dimaib/Current_meter/schematic_pcb/current_rich/спецификация.xlsx

На схеме | Номинал | Артикул | Ссылка | Цена за шт | Кол-во | Цена общ
C2 | CP | TKR470M1JE11 | https://www.chipdip.ru/product0/995239112 | 11 | 1 | 11
> C1, C3, C5-C7, C9 | 0.1uF | MLCC0.1uFY5V50V+80-20%0805 | https://www.chipdip.ru/product0/642412305 | 4 | 6 | 24
C4 | 68uF | ECASD40G686M020K00 | https://www.chipdip.ru/product/ecasd40g686m020k | 15 | 1 | 15
C8 | 10uF | GRM21BR60J106KE19L | https://www.chipdip.ru/product/grm21br60j106k | 4 | 1 | 4
> D1, D2 | SS16 | SS16 | https://www.chipdip.ru/product/ss16 | 4 | 2 | 8
J1 | USB_B_Micro | USB/M-1J (DS1104) | https://www.chipdip.ru/product/usb-m-1j | 23 | 1 | 23
J2 | Conn_01x04 | PLS-4R (DS1022-1x4R) | https://www.chipdip.ru/product/pls-4r | 6 | 1 | 6
J3 | Conn_01x08 | DG308-2.54-02P-14-00AH | https://www.chipdip.ru/product/dg308-2.54-02p-14-00ah | 9 | 4 | 36
L1 | 1000uH | LQH55DN102M03L | https://www.chipdip.ru/product/lqh55dn102m03l | 34 | 1 | 34
pack1 | box | КР-7 "На защелках" (Черный) | https://www.chipdip.ru/product0/9000309028 | 140 | 1 | 140
> Q1-Q4 | BC817 | BC817-16.215 | https://www.chipdip.ru/product/bc817-16-nxp | 3 | 4 | 12
> R1, R2 | R |  |  |  | 2 | 0
R3 | 1.2k | 0.1Вт 0603 1.2 кОм, 1% | https://www.chipdip.ru/product0/9000079678 | 0.9 | 1 | 0.9
R4 | 680 | 0.1Вт 0603 680 Ом, 1% | https://www.chipdip.ru/product0/9000079672 | 0.9 | 1 | 0.9
> R5-R16 | 220 | 0.1Вт 0603 220 Ом, 1% | https://www.chipdip.ru/product0/9000079624 | 0.9 | 12 | 10.8
> R17, R22 | 100 | 0.1Вт 0603 100 Ом, 1% | https://www.chipdip.ru/product0/9000079616 | 0.9 | 2 | 1.8
> R18, R19, R21 | 10k | 0.1Вт 0603 10 кОм, 1% | https://www.chipdip.ru/product0/9000079736 | 0.9 | 3 | 2.7
R20 | 100k | 0.1Вт 0603 100 кОм, 1% | https://www.chipdip.ru/product0/9000079760 | 0.9 | 1 | 0.9
R23 | 5.6k | 0.1Вт 0603 5.6 кОм, 1% | https://www.chipdip.ru/product0/9000079730 | 0.9 | 1 | 0.9
SW1 | Reset | 1437566-3 (FSMSM) | https://www.chipdip.ru/product/tyco-1437566-3-fsmsm | 22 | 1 | 22
SW2 | Boot0 | 1437566-3 (FSMSM) | https://www.chipdip.ru/product/tyco-1437566-3-fsmsm | 22 | 1 | 22
SW3 | Sys | 1437566-3 (FSMSM) | https://www.chipdip.ru/product/tyco-1437566-3-fsmsm | 22 | 1 | 22
U1 | STM32F030F4P6 | STM32F030F4P6 | https://www.chipdip.ru/product/stm32f030f4p6 | 40 | 1 | 40
U2 | CC56-12GWA | CC56-12GWA | https://www.chipdip.ru/product/cc56-12gwa | 210 | 1 | 210
U3 | MAX5035AUSA | MAX5035BASA+T | https://www.chipdip.ru/product/max5035basa | 150 | 1 | 150
U4 | 74HC595 | 74HC595D,118 | https://www.chipdip.ru/product/74hc595d | 10 | 1 | 10
> U8, U11 | LM321 | LM321MF/NOPB | https://www.chipdip.ru/product/lm321mf-nopb-3 | 27 | 2 | 54
U9 | AP1117-33 | AMS1117-3.3 | https://www.chipdip.ru/product/ams1117-3.3 | 16 | 1 | 16
U10 | CP2102N-A01-GQFN28 | CP2102-GMR | https://www.chipdip.ru/product/cp2102-gmr | 110 | 1 | 110
 |  |  |  | Итого: |  | 987.9
