dimaib/Current_meter/schematic_pcb/current_rich/контур платы.dxf

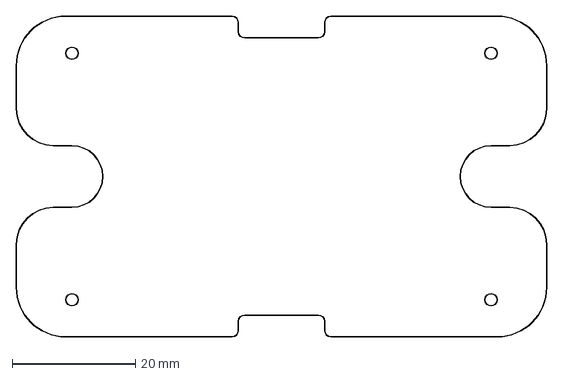
[picture p1: CAD file, 2022-04-17]
schematic_pcb/current_rich/контур платы.dxf
86.0 x 52.0 mm
