dimaib/Current_meter/schematic_pcb/current_rich/current_rich.kicad_pcb

## KiCad design schematic_pcb/current_rich/current_rich.kicad_pcb (2022-04-17)

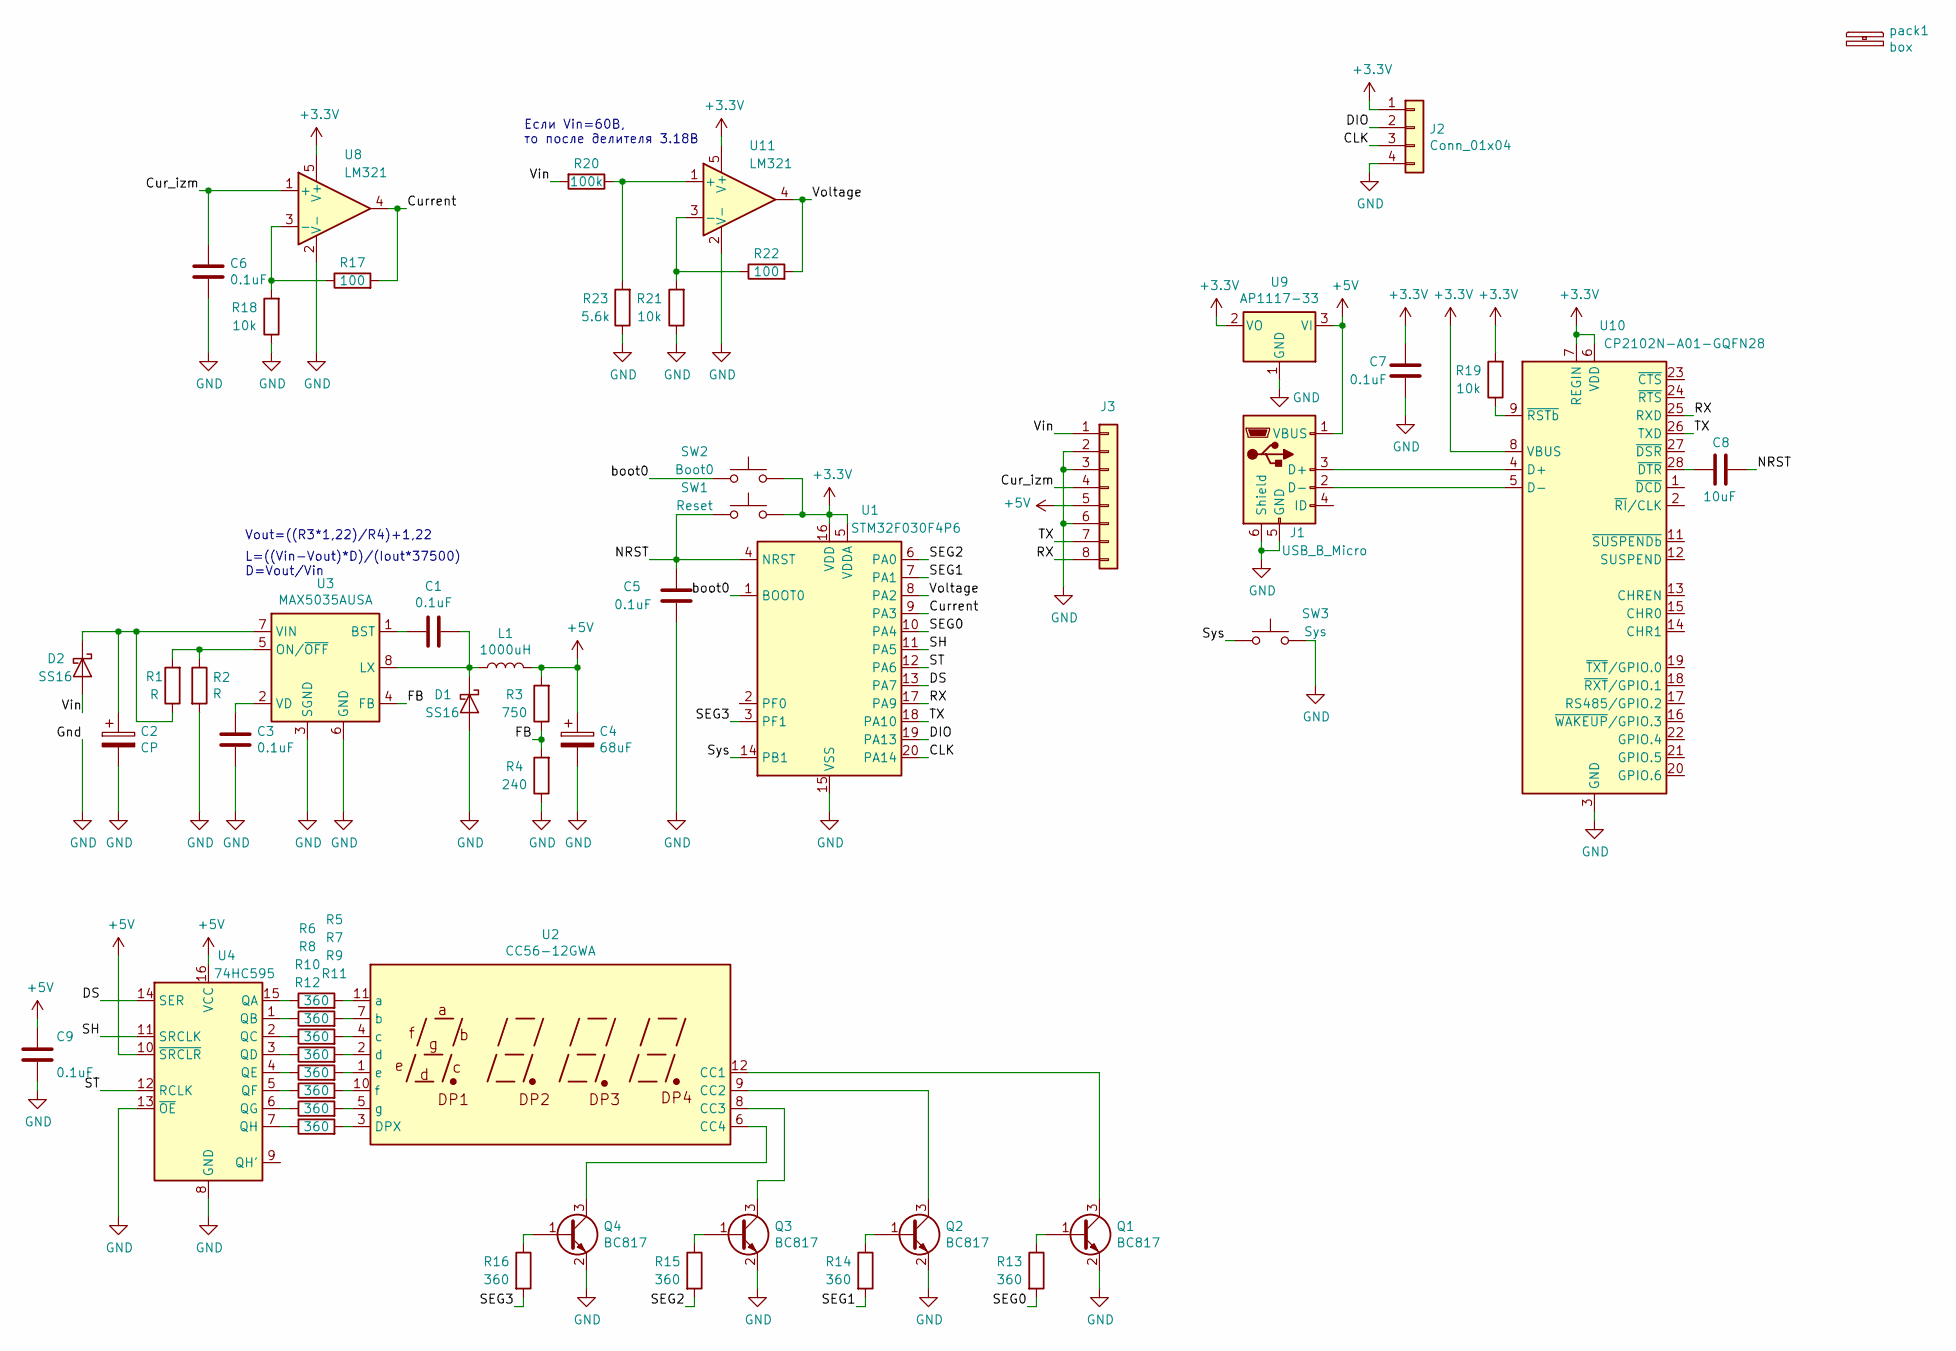
[picture p2: schematic current_rich.sch]

Parts:
C1, C3, C5, C6, C7, C9: 0.1uF; C_0805_2012Metric
C2: CP; CP_Radial_D6.3mm_P2.50mm
C4: 68uF; CP_EIA-7343-20_Kemet-V
C8: 10uF; C_0805_2012Metric
D1, D2: SS16; D_SMA
J1: USB_B_Micro; USB_Mini-B_Lumberg_2486_01_Horizontal
J2: Conn_01x04; PinHeader_1x04_P2.54mm_Horizontal
J3: Conn_01x08; DG308_08
L1: 1000uH; L_2220_inductor
Q1, Q2, Q3, Q4: BC817; SOT-23
R1, R2: R; R_0805_2012Metric
R3: 750; R_0805_2012Metric
R4: 240; R_0805_2012Metric
R5, R6, R7, R8, R9, R10, R11, R12, R13, R14, R15, R16: 360; R_0603_1608Metric
R17, R22: 100; R_0603_1608Metric
R18, R19, R21: 10k; R_0603_1608Metric
R20: 100k; R_0603_1608Metric
R23: 5.6k; R_0603_1608Metric
SW1: Reset; SW_SPST_FSMSM
SW2: Boot0; SW_SPST_FSMSM
SW3: Sys; SW_SPST_FSMSM
U1: STM32F030F4P6; TSSOP-20_4.4x6.5mm_P0.65mm
U2: CC56-12GWA
U3: MAX5035AUSA; SOIC-8_3.9x4.9mm_P1.27mm
U4: 74HC595; SOIC-16_3.9x9.9mm_P1.27mm
U8, U11: LM321; SOT-23-5
U9: AP1117-33; SOT-223-3_TabPin2
U10: CP2102N-A01-GQFN28; QFN-28-1EP_5x5mm_P0.5mm_EP3.35x3.35mm
pack1: box

Connections:
+3V3: C7.2, J2.1, R19.2, SW1.2, SW2.2, U1.5 (VDDA), U1.16 (VDD), U8.5 (V+), U9.2 (VO), U10.6 (VDD), U10.7 (REGIN), U10.8 (VBUS), U11.5 (V+)
+5V: C4.1, C9.2, J1.1 (VBUS), J3.5, L1.2, R3.2, U4.10 (~SRCLR), U4.16 (VCC), U9.3 (VI)
/CLK: J2.3, U1.20 (PA14)
/Cur_izm: C6.1, J3.4, U8.1 (+)
/Current: R17.2, U1.9 (PA3), U8.4
/DIO: J2.2, U1.19 (PA13)
/DS: U1.13 (PA7), U4.14 (SER)
/FB: R3.1, R4.2, U3.4 (FB)
/NRST: C5.2, C8.1, SW1.1, U1.4 (NRST)
/RX: J3.8, U1.17 (PA9), U10.25 (RXD)
/SEG0: R13.2, U1.10 (PA4)
/SEG1: R14.2, U1.7 (PA1)
/SEG2: R15.2, U1.6 (PA0)
/SEG3: R16.2, U1.3 (PF1)
/SH: U1.11 (PA5), U4.11 (SRCLK)
/ST: U1.12 (PA6), U4.12 (RCLK)
/Sys: SW3.1, U1.14 (PB1)
/TX: J3.7, U1.18 (PA10), U10.26 (TXD)
/Vin: D2.2 (A), J3.1, R20.2
/Voltage: R22.2, U1.8 (PA2), U11.4
/boot0: SW2.1, U1.1 (BOOT0)
GND: C2.2, C3.2, C4.2, C5.1, C6.2, C7.1, C9.1, D1.2 (A), J1.5 (GND), J1.6 (Shield), J2.4, J3.2, J3.3, J3.6, Q1.2 (E), Q2.2 (E), Q3.2 (E), Q4.2 (E), R2.2, R4.1, R18.1, R21.1, R23.1, SW3.2, U1.15 (VSS), U3.3 (SGND), U3.6 (GND), U4.8 (GND), U4.13 (~OE), U8.2 (V-), U9.1 (GND), U10.3 (GND), U10.29 (GND), U11.2 (V-)
unnamed: C1.1, D1.1 (K), L1.1, U3.8 (LX)
unnamed: C1.2, U3.1 (BST)
unnamed: C2.1, D2.1 (K), R1.1, U3.7 (VIN)
unnamed: C3.1, U3.2 (VD)
unnamed: C8.2, U10.28 (~DTR)
unnamed: J1.2 (D-), U10.5 (D-)
unnamed: J1.3 (D+), U10.4 (D+)
unnamed: Q1.1 (B), R13.1
unnamed: Q1.3 (C), U2.12 (CC1)
unnamed: Q2.1 (B), R14.1
unnamed: Q2.3 (C), U2.9 (CC2)
unnamed: Q3.1 (B), R15.1
unnamed: Q3.3 (C), U2.8 (CC3)
unnamed: Q4.1 (B), R16.1
unnamed: Q4.3 (C), U2.6 (CC4)
unnamed: R1.2, R2.1, U3.5 (ON/~OFF~)
unnamed: R5.1, U4.15 (QA)
unnamed: R5.2, U2.11 (a)
unnamed: R6.1, U4.1 (QB)
unnamed: R6.2, U2.7 (b)
unnamed: R7.1, U4.2 (QC)
unnamed: R7.2, U2.4 (c)
unnamed: R8.1, U4.3 (QD)
unnamed: R8.2, U2.2 (d)
unnamed: R9.1, U4.4 (QE)
unnamed: R9.2, U2.1 (e)
unnamed: R10.1, U4.5 (QF)
unnamed: R10.2, U2.10 (f)
unnamed: R11.1, U4.6 (QG)
unnamed: R11.2, U2.5 (g)
unnamed: R12.1, U4.7 (QH)
unnamed: R12.2, U2.3 (DPX)
unnamed: R17.1, R18.2, U8.3 (-)
unnamed: R19.1, U10.9 (~RSTb)
unnamed: R20.1, R23.2, U11.1 (+)
unnamed: R21.2, R22.1, U11.3 (-)

Notes on the sheet:
Vout=((R3*1,22)/R4)+1,22
L=((Vin-Vout)*D)/(Iout*37500) D=Vout/Vin
Если Vin=60В, то после делителя 3.18В

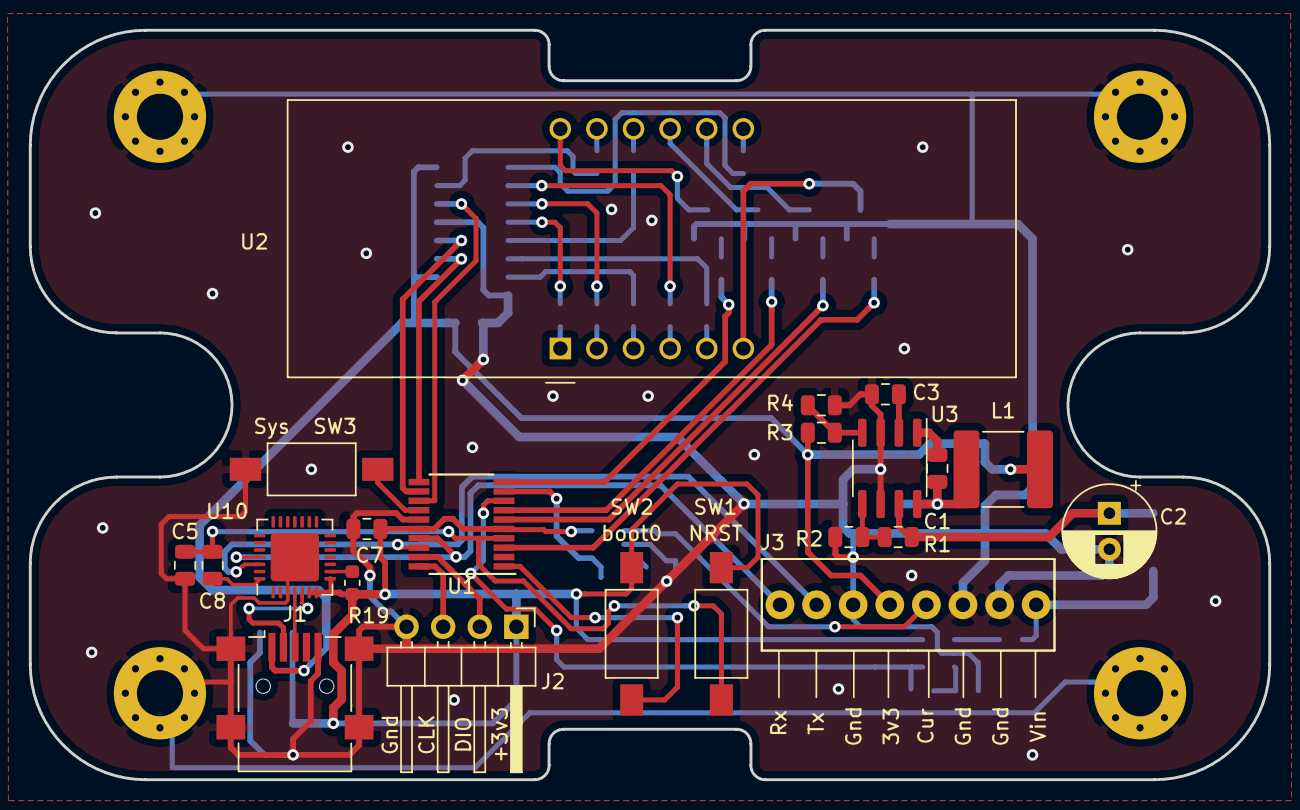
[picture p3: board current_rich.kicad_pcb from above]

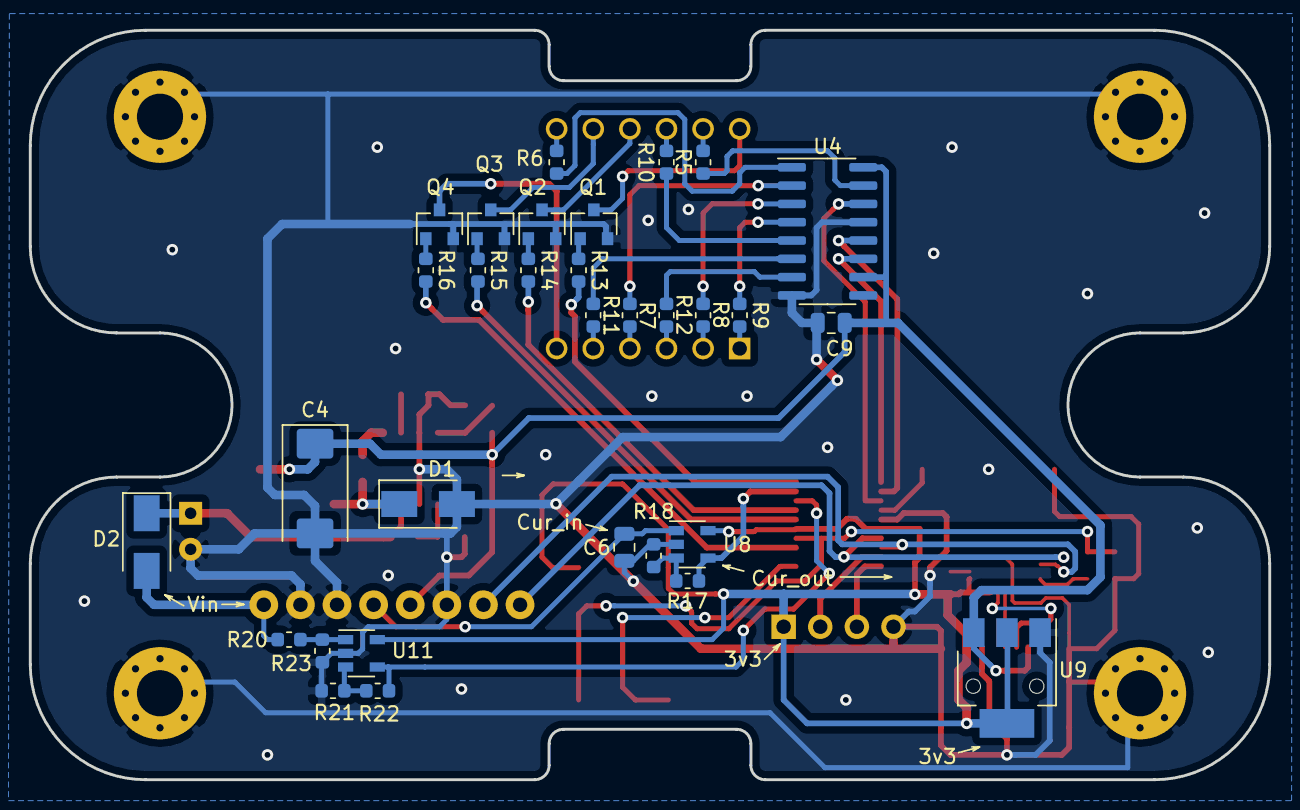
[picture p4: board current_rich.kicad_pcb from below]

Board: 2 copper layers, 86.0 x 52.0 mm, 53 parts (31 on the bottom side), 58 nets.
