dimaib/Current_meter/Software/Cur_sensor/Inc/main.h

#define SEG3_Pin GPIO_PIN_1
#define SEG3_GPIO_Port GPIOF
#define SEG2_Pin GPIO_PIN_0
#define SEG2_GPIO_Port GPIOA
#define SEG1_Pin GPIO_PIN_1
#define SEG1_GPIO_Port GPIOA
#define VOLTAGE_Pin GPIO_PIN_2
#define VOLTAGE_GPIO_Port GPIOA
#define CURRENT_Pin GPIO_PIN_3
#define CURRENT_GPIO_Port GPIOA
#define SEG0_Pin GPIO_PIN_4
#define SEG0_GPIO_Port GPIOA
#define SH_Pin GPIO_PIN_5
#define SH_GPIO_Port GPIOA
#define ST_Pin GPIO_PIN_6
#define ST_GPIO_Port GPIOA
#define DS_Pin GPIO_PIN_7
#define DS_GPIO_Port GPIOA
#define SYS_BUTTON_Pin GPIO_PIN_1
#define SYS_BUTTON_GPIO_Port GPIOB
